ksmola/inverter-hardware/prius_gen2_kicad/prius_g2_cam/bom_jlc_order.xls

Comment | Designator | Package | LCSC Part
0603WAF1201T5E | R50,R51,R52,R53,R54 | Resistor_SMD:R_0603_1608Metric | C22765
PESD1CAN-UX | D2 | Package_TO_SOT_SMD:SOT-323_SC-70 | C152727
SMCJ30CA-TR | D4 | Diode_SMD:D_SMC | C152081
CL10B102KB8NNNC | C15,C16,C43,C44,C19 | Capacitor_SMD:C_0603_1608Metric | C1588
0603WAF2200T5E | R23 | Resistor_SMD:R_0603_1608Metric | C22962
TDA2822G-S08-R | U4 | Package_SO:SOIC-8-1EP_3.9x4.9mm_P1.27mm_EP2.29x3mm | C73296
GZ2012D101TF | FB1 | Capacitor_SMD:C_0805_2012Metric | C1015
CL10C331JB8NNNC | C39 | Capacitor_SMD:C_0603_1608Metric | C1664
MWSA0503-100MT | L2 | prius_gen2_kicad:MWSA0503 | C139506
0603WAF1202T5E | R39 | Resistor_SMD:R_0603_1608Metric | C22790
0603WAF5100T5E | R22,R41,R42,R55,R58,R59 | Resistor_SMD:R_0603_1608Metric | C23193
X50328MSB2GI | Y1 | Crystal:Crystal_SMD_5032-2Pin_5.0x3.2mm | C115962
CL10A475KO8NNNC | C34,C42,C3,C5,C6,C7,C8,C12 | Capacitor_SMD:C_0603_1608Metric | C19666
ESP32-WROOM-32 | U6 | RF_Module:ESP32-WROOM-32 | C82899
0603B103K500NT | C4,C10,C37 | Capacitor_SMD:C_0603_1608Metric | C57112
0603WAF1200T5E | R33 | Resistor_SMD:R_0603_1608Metric | C22787
CL10B223KB8NNNC | C22,C23,C24,C25,C27 | Capacitor_SMD:C_0603_1608Metric | C21122
CL10A106KP8NNNC | C26,C32,C18,C40,C41 | Capacitor_SMD:C_0603_1608Metric | C19702
TS-1187A-C-E-B | SW1,SW2,SW4,SW3 | Button_Switch_SMD:SW_SPST_EVQQ2 | C318887
AP9T18GH-HF | Q1,Q2 | Package_TO_SOT_SMD:TO-252-2 | C124546
0603WAF1002T5E | R4,R5,R6,R11,R18,R19,R20,R21,R24,R26,R1,R3,R30,R36,R38,R43,R44,R56,R57,R60,R61,R34 | Resistor_SMD:R_0603_1608Metric | C25804
LMR14020SDDAR | U7 | Package_SO:SOIC-8-1EP_3.9x4.9mm_P1.27mm_EP2.29x3mm | C187824
0603WAF3301T5E | R27,R28,R29,R46,R47,R48,R49 | Resistor_SMD:R_0603_1608Metric | C22978
0603WAF100KT5E | R37 | Resistor_SMD:R_0603_1608Metric | C22936
E6C0603QBAC1UDA | D1,D3 | LED_SMD:LED_0603_1608Metric_Castellated | C375446
MCP6022T-I/SN | U2 | Package_SO:SOIC-8-1EP_3.9x4.9mm_P1.27mm_EP2.29x3mm | C57639
0603WAF1000T5E | R35 | Resistor_SMD:R_0603_1608Metric | C22775
STM32F103R8T6 | U1 | Package_QFP:LQFP-64_10x10mm_P0.5mm | C46034
0603B104K250CT | C28,C29 | Capacitor_SMD:C_0603_1608Metric | C83054
CL10A105KB8NNNC | C14,C17,C45,C46,C47,C48,C49,C50,C51,C52,C20,C36 | Capacitor_SMD:C_0603_1608Metric | C15849
0603WAF1502T5E | R13,R15 | Resistor_SMD:R_0603_1608Metric | C22809
0603WAF3302T5E | R12,R14 | Resistor_SMD:R_0603_1608Metric | C4216
ULN2003ADR | U3 | Package_SO:SOIC-16_4.55x10.3mm_P1.27mm | C7512
0603WAF6800T5E | R2 | Resistor_SMD:R_0603_1608Metric | C23228
SS34 | D5,D6 | Diode_SMD:D_SMA | C8678
CC0603KRX7R9BB104 | C38 | Capacitor_SMD:C_0603_1608Metric | C14663
0603WAF6802T5E | R40 | Resistor_SMD:R_0603_1608Metric | C23231
TJA1051T/3/1J | U5 | Package_SO:SOIC-8_3.9x4.9mm_P1.27mm | C38695
CL10C330JB8NNNC | C1,C2 | Capacitor_SMD:C_0603_1608Metric | C1663
HMK107B7104KAHT | C30,C31,C33 | Capacitor_SMD:C_0603_1608Metric | C268011
AMS1117-3.3 | U8 | Package_TO_SOT_SMD:SOT-223-3_TabPin2 | C6186
LQH32PN2R2NN0L | L1 | Inductor_SMD:L_1210_3225Metric | C86074
0805W8F4701T5E | R25,R31,R32,R45 | Resistor_SMD:R_0603_1608Metric | C23162
0603WAF1003T5E | R7,R8,R9,R10,R16,R17 | Resistor_SMD:R_0603_1608Metric | C25803
