ksmola/inverter-hardware/prius_gen2_kicad/prius_gen2.kicad_pcb

## KiCad design prius_gen2_kicad/prius_gen2.kicad_pcb (2021-07-11)

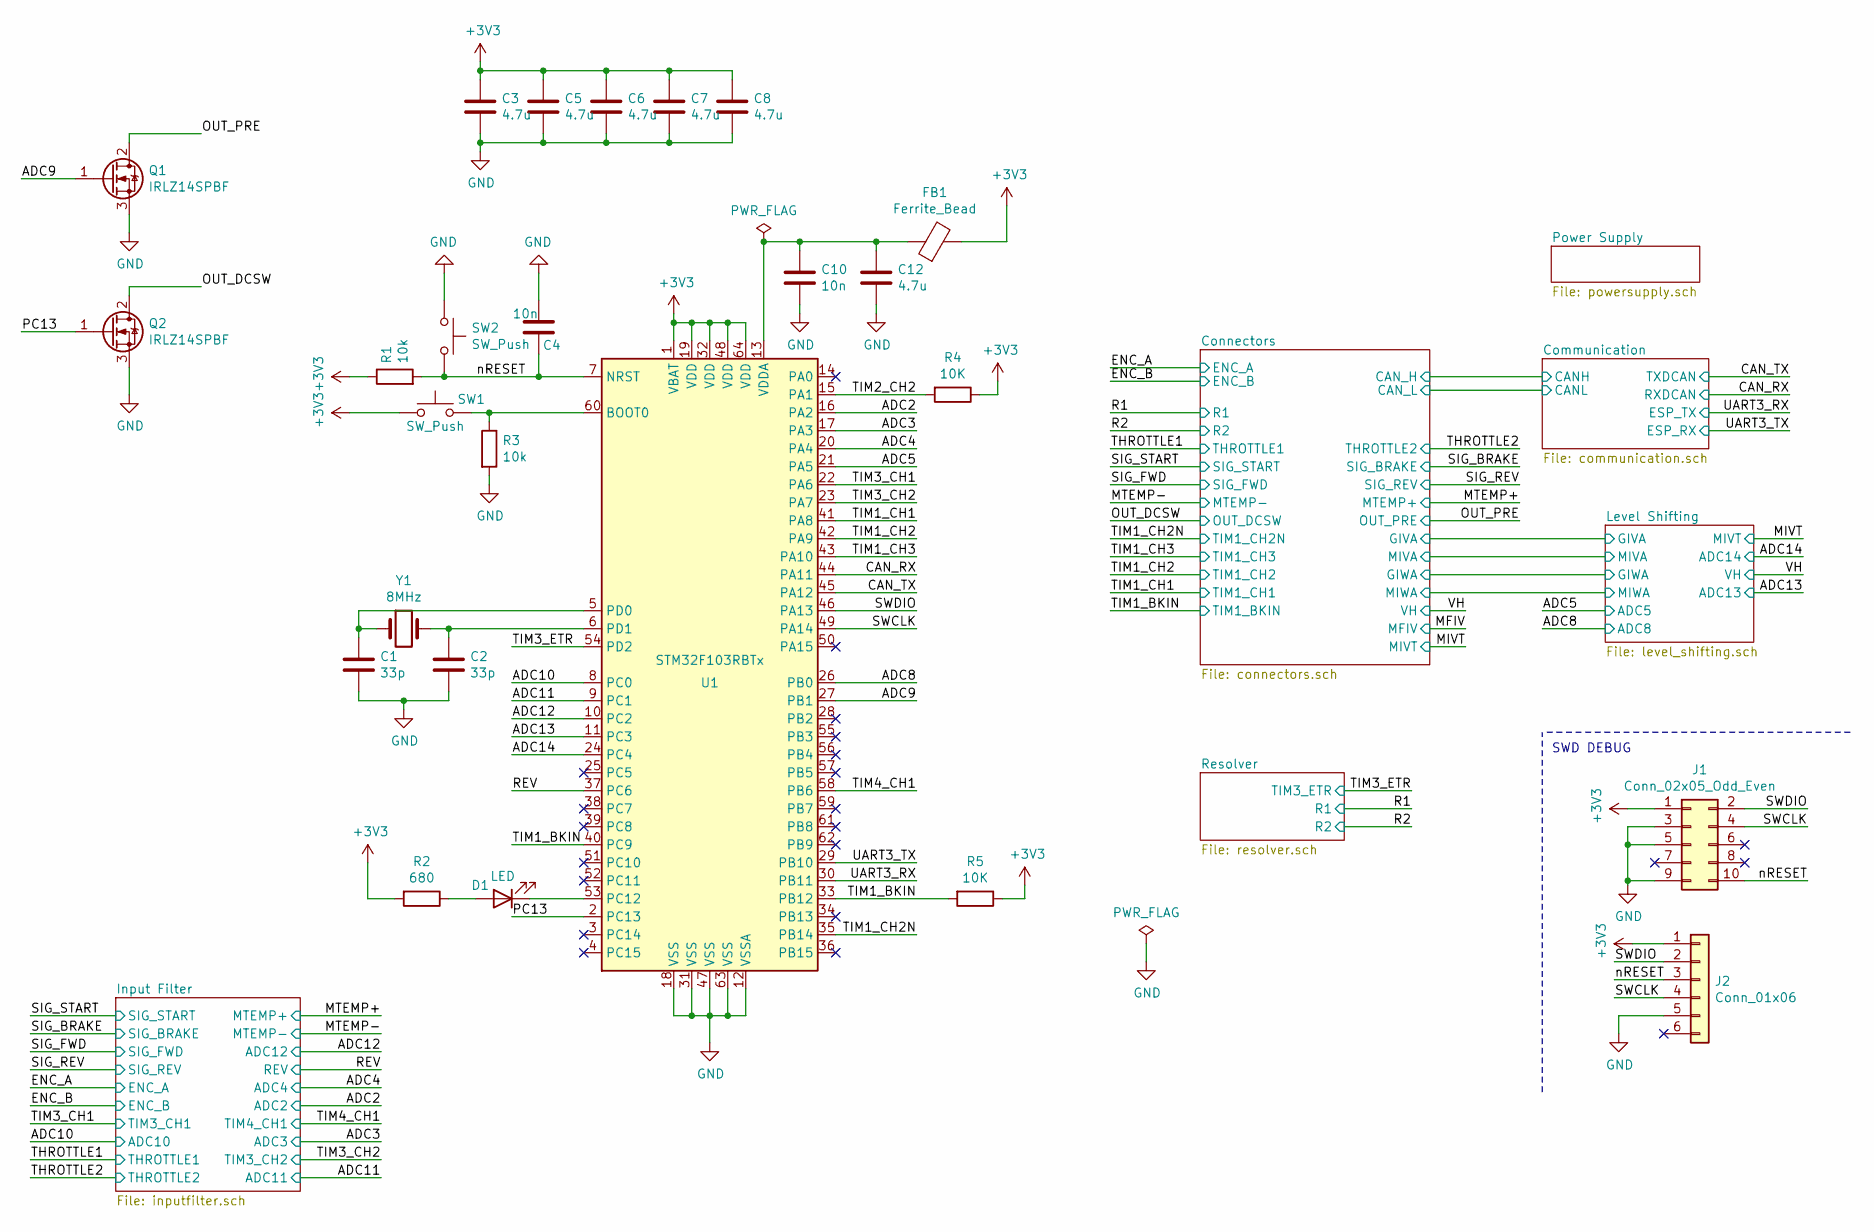
[picture p1: schematic prius_gen2.sch]

Parts:
C1, C2: 33p; C_0603_1608Metric
C3, C5, C6, C7, C8, C12: 4.7u; C_0603_1608Metric
C4, C10: 10n; C_0603_1608Metric
D1: LED; LED_0603_1608Metric_Castellated
FB1: Ferrite_Bead; C_0805_2012Metric
J1: Conn_02x05_Odd_Even; PinHeader_2x05_P1.27mm_Vertical_SMD
J2: Conn_01x06; Tag-Connect_TC2030-IDC-NL_2x03_P1.27mm_Vertical
Q1, Q2: IRLZ14SPBF; TO-252-2
R1, R3: 10k; R_0603_1608Metric
R2: 680; R_0603_1608Metric
R4, R5: 10K; R_0603_1608Metric
SW1, SW2: SW_Push; SW_SPST_EVQQ2
U1: STM32F103RBTx; LQFP-64_10x10mm_P0.5mm
Y1: 8MHz; Crystal_SMD_5032-2Pin_5.0x3.2mm

Connections:
/ADC2: U1.16 (PA2); also elsewhere on the board
/ADC3: U1.17 (PA3); also elsewhere on the board
/ADC4: U1.20 (PA4); also elsewhere on the board
/ADC5: U1.21 (PA5); also elsewhere on the board
/ADC8: U1.26 (PB0); also elsewhere on the board
/ADC9: Q1.1 (G), U1.27 (PB1)
/ADC10: U1.8 (PC0); also elsewhere on the board
/ADC11: U1.9 (PC1); also elsewhere on the board
/ADC12: U1.10 (PC2); also elsewhere on the board
/ADC13: U1.11 (PC3); also elsewhere on the board
/ADC14: U1.24 (PC4); also elsewhere on the board
/CAN_RX: U1.44 (PA11); also elsewhere on the board
/CAN_TX: U1.45 (PA12); also elsewhere on the board
/OUT_DCSW: Q2.2 (D); also elsewhere on the board
/OUT_PRE: Q1.2 (D); also elsewhere on the board
/PC13: Q2.1 (G), U1.2 (PC13)
/REV: U1.37 (PC6); also elsewhere on the board
/SWCLK: J1.4, J2.4, U1.49 (PA14)
/SWDIO: J1.2, J2.2, U1.46 (PA13)
/TIM1_BKIN: R5.2, U1.33 (PB12), U1.40 (PC9); also elsewhere on the board
/TIM1_CH1: U1.41 (PA8); also elsewhere on the board
/TIM1_CH2: U1.42 (PA9); also elsewhere on the board
/TIM1_CH2N: U1.35 (PB14); also elsewhere on the board
/TIM1_CH3: U1.43 (PA10); also elsewhere on the board
/TIM2_CH2: R4.2, U1.15 (PA1)
/TIM3_CH1: U1.22 (PA6); also elsewhere on the board
/TIM3_CH2: U1.23 (PA7); also elsewhere on the board
/TIM3_ETR: U1.54 (PD2); also elsewhere on the board
/TIM4_CH1: U1.58 (PB6); also elsewhere on the board
/UART3_RX: U1.30 (PB11); also elsewhere on the board
/UART3_TX: U1.29 (PB10); also elsewhere on the board
/nRESET: C4.1, J1.10, J2.3, R1.2, SW2.2, U1.7 (NRST)
GND: C1.1, C2.1, C3.2, C4.2, C5.2, C6.2, C7.2, C8.2, C10.2, C12.2, J1.3, J1.5, J1.9, J2.5, Q1.3 (S), Q2.3 (S), R3.2, SW2.1, U1.12 (VSSA), U1.18 (VSS), U1.31 (VSS), U1.47 (VSS), U1.63 (VSS); also elsewhere on the board
unnamed: C1.2, U1.5 (PD0), Y1.1
unnamed: C2.2, U1.6 (PD1), Y1.2
unnamed: C10.1, C12.1, FB1.1, U1.13 (VDDA)
unnamed: D1.1 (K), U1.53 (PC12)
unnamed: D1.2 (A), R2.1
unnamed: R3.1, SW1.2, U1.60 (BOOT0)

Notes on the sheet:
SWD DEBUG

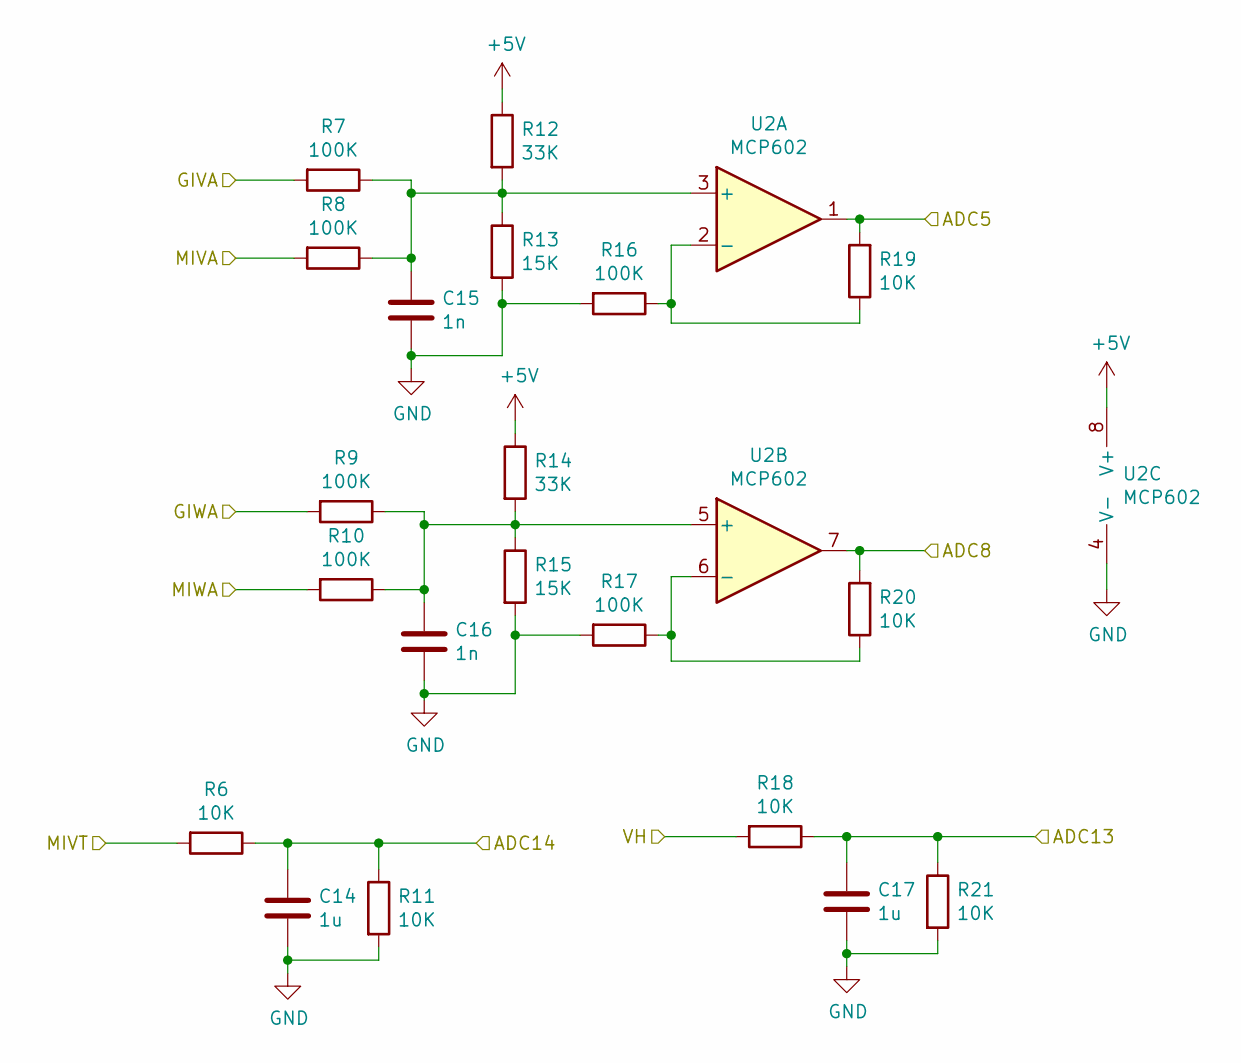
[picture p2: schematic level_shifting.sch]

Parts:
C14, C17: 1u; C_0603_1608Metric
C15, C16: 1n; C_0603_1608Metric
R6, R11, R18, R19, R20, R21: 10K; R_0603_1608Metric
R7, R8, R9, R10, R16, R17: 100K; R_0603_1608Metric
R12, R14: 33K; R_0603_1608Metric
R13, R15: 15K; R_0603_1608Metric
U2: MCP602; SOIC-8-1EP_3.9x4.9mm_P1.27mm_EP2.29x3mm

Connections:
+5V: R12.1, R14.1, U2.8 (V+); also elsewhere on the board
/ADC5: R19.2, U2.1; also elsewhere on the board
/ADC8: R20.2, U2.7; also elsewhere on the board
/ADC13: C17.1, R18.1, R21.1; also elsewhere on the board
/ADC14: C14.1, R6.1, R11.1; also elsewhere on the board
/Connectors/GIVA: R7.2; also elsewhere on the board
/Connectors/GIWA: R9.2; also elsewhere on the board
/Connectors/MIVA: R8.2; also elsewhere on the board
/Connectors/MIWA: R10.2; also elsewhere on the board
/MIVT: R6.2; also elsewhere on the board
/VH: R18.2; also elsewhere on the board
GND: C14.2, C15.2, C16.2, C17.2, R11.2, R13.2, R15.2, R16.2, R17.2, R21.2, U2.4 (V-); also elsewhere on the board
unnamed: C15.1, R7.1, R8.1, R12.2, R13.1, U2.3 (+)
unnamed: C16.1, R9.1, R10.1, R14.2, R15.1, U2.5 (+)
unnamed: R16.1, R19.1, U2.2 (-)
unnamed: R17.1, R20.1, U2.6 (-)

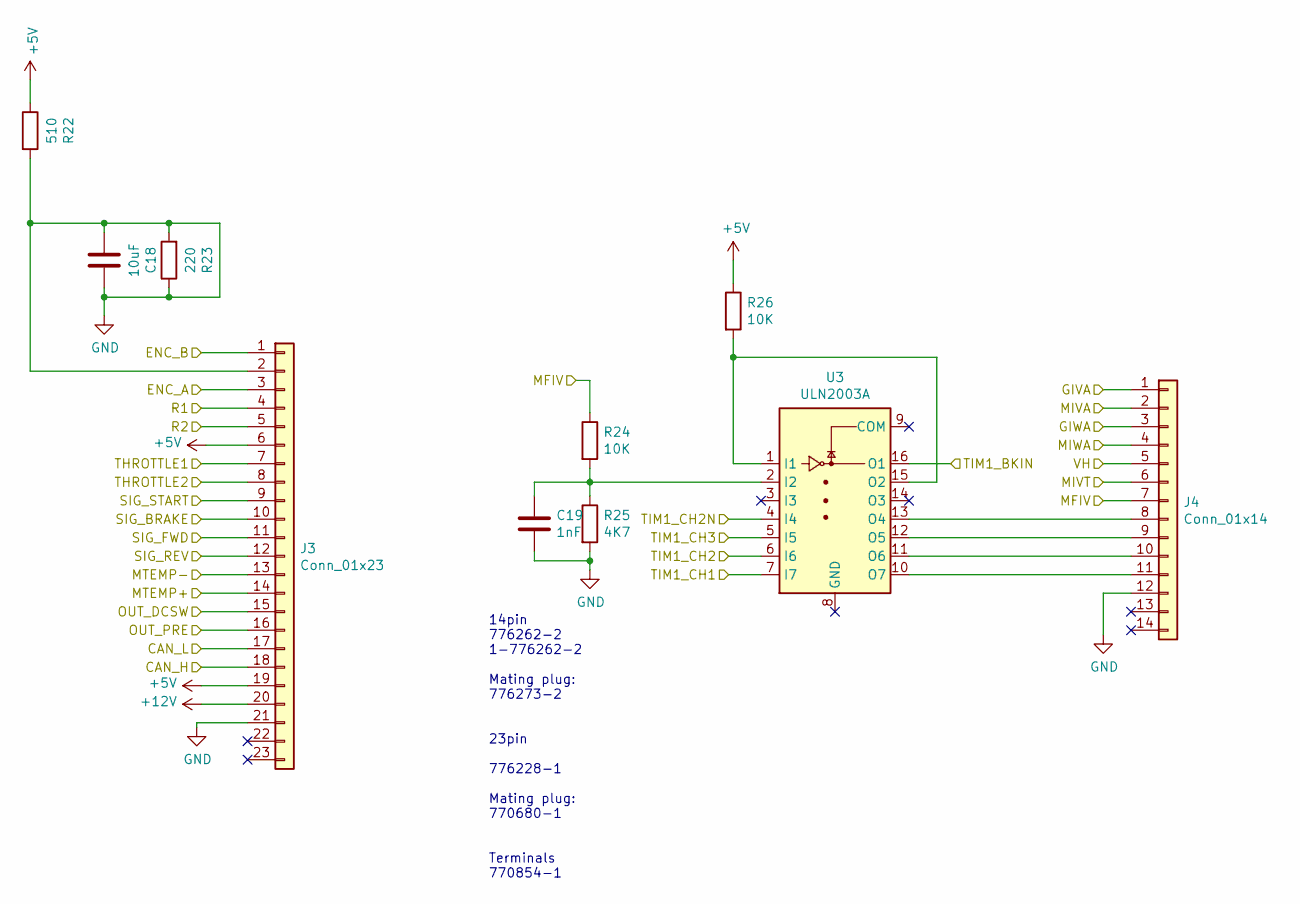
[picture p3: schematic connectors.sch]

Parts:
C18: 10uF; C_0603_1608Metric
C19: 1nF; C_0603_1608Metric
J3: Conn_01x23; TE_776228-1
J4: Conn_01x14; TE_776262-2
R22: 510; R_0603_1608Metric
R23: 220; R_0603_1608Metric
R24, R26: 10K; R_0603_1608Metric
R25: 4K7; R_0603_1608Metric
U3: ULN2003A; SOIC-16_4.55x10.3mm_P1.27mm

Connections:
+5V: J3.6, J3.19, R22.1, R26.1; also elsewhere on the board
+12V: J3.20; also elsewhere on the board
/Communication/CANH: J3.18; also elsewhere on the board
/Communication/CANL: J3.17; also elsewhere on the board
/Connectors/GIVA: J4.1; also elsewhere on the board
/Connectors/GIWA: J4.3; also elsewhere on the board
/Connectors/MIVA: J4.2; also elsewhere on the board
/Connectors/MIWA: J4.4; also elsewhere on the board
/ENC_A: J3.3; also elsewhere on the board
/ENC_B: J3.1; also elsewhere on the board
/MFIV: J4.7, R24.1
/MIVT: J4.6; also elsewhere on the board
/MTEMP+: J3.14; also elsewhere on the board
/MTEMP-: J3.13; also elsewhere on the board
/OUT_DCSW: J3.15; also elsewhere on the board
/OUT_PRE: J3.16; also elsewhere on the board
/R1: J3.4; also elsewhere on the board
/R2: J3.5; also elsewhere on the board
/SIG_BRAKE: J3.10; also elsewhere on the board
/SIG_FWD: J3.11; also elsewhere on the board
/SIG_REV: J3.12; also elsewhere on the board
/SIG_START: J3.9; also elsewhere on the board
/THROTTLE1: J3.7; also elsewhere on the board
/THROTTLE2: J3.8; also elsewhere on the board
/TIM1_BKIN: U3.16 (O1); also elsewhere on the board
/TIM1_CH1: U3.7 (I7); also elsewhere on the board
/TIM1_CH2: U3.6 (I6); also elsewhere on the board
/TIM1_CH2N: U3.4 (I4); also elsewhere on the board
/TIM1_CH3: U3.5 (I5); also elsewhere on the board
/VH: J4.5; also elsewhere on the board
GND: C18.1, C18.2, C19.2, J3.2, J3.21, J4.12, R22.2, R23.1, R23.2, R25.2; also elsewhere on the board
unnamed: C19.1, R24.2, R25.1, U3.2 (I2)
unnamed: J4.8, U3.13 (O4)
unnamed: J4.9, U3.12 (O5)
unnamed: J4.10, U3.11 (O6)
unnamed: J4.11, U3.10 (O7)
unnamed: R26.2, U3.1 (I1), U3.15 (O2)

Notes on the sheet:
14pin 776262-2 1-776262-2 Mating plug: 776273-2 23pin 776228-1 Mating plug: 770680-1 Terminals 770854-1

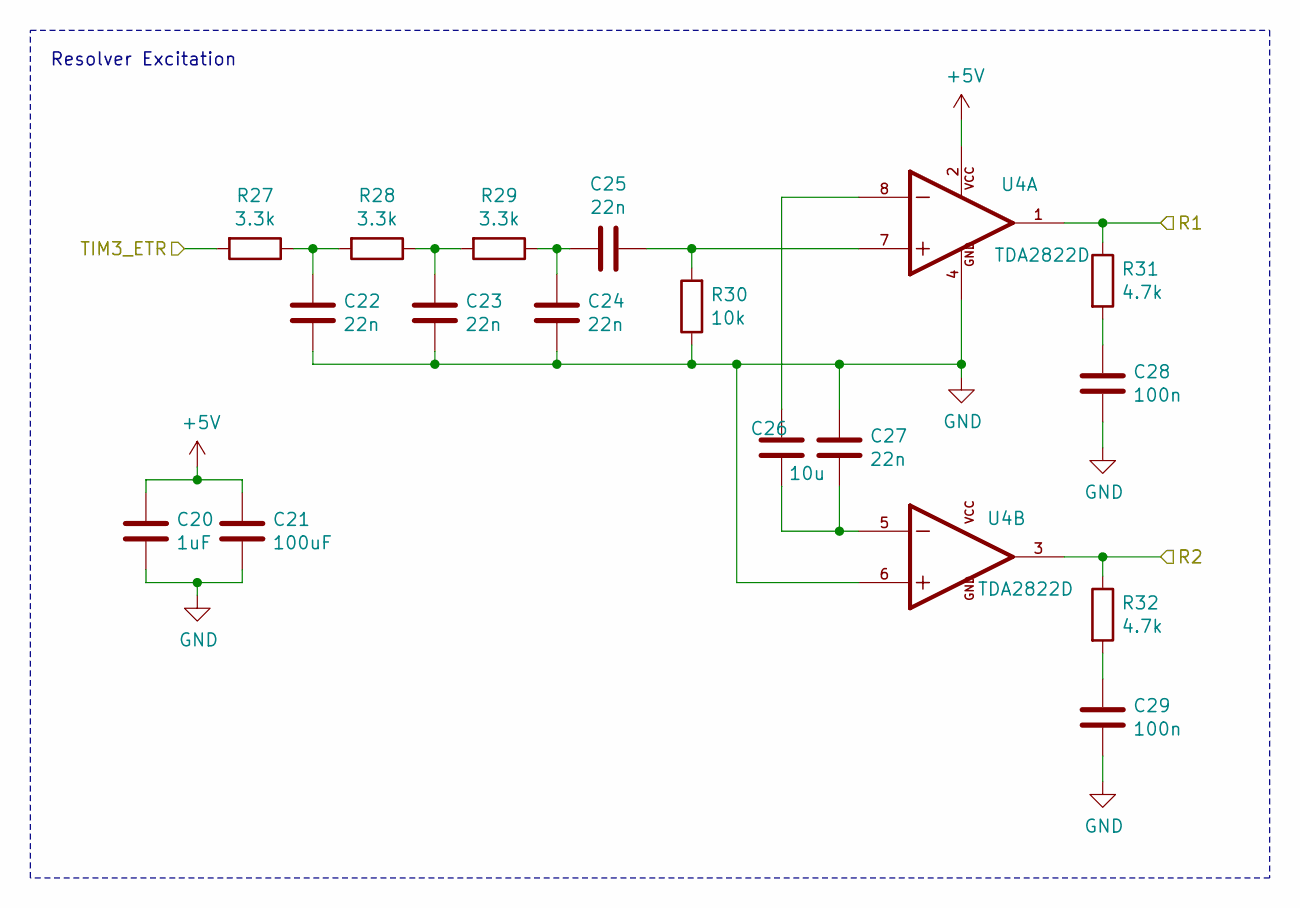
[picture p4: schematic resolver.sch]

Parts:
C20: 1uF; C_0603_1608Metric
C21: 100uF; C_Elec_6.3x7.7
C22, C23, C24, C25, C27: 22n; C_0603_1608Metric
C26: 10u; C_0603_1608Metric
C28, C29: 100n; C_0603_1608Metric
R27, R28, R29: 3.3k; R_0603_1608Metric
R30: 10k; R_0603_1608Metric
R31, R32: 4.7k; R_0603_1608Metric
U4: TDA2822D; SOIC-8-1EP_3.9x4.9mm_P1.27mm_EP2.29x3mm; PARTREV September 2003

Connections:
+5V: C20.1, C21.1, U4.2; also elsewhere on the board
/R1: R31.1, U4.1; also elsewhere on the board
/R2: R32.1, U4.3; also elsewhere on the board
/TIM3_ETR: R27.2; also elsewhere on the board
GND: C20.2, C21.2, C22.2, C23.2, C24.2, C27.1, C28.2, C29.2, R30.1, U4.4, U4.6; also elsewhere on the board
unnamed: C22.1, R27.1, R28.2
unnamed: C23.1, R28.1, R29.2
unnamed: C24.1, C25.2, R29.1
unnamed: C25.1, R30.2, U4.7
unnamed: C26.1, U4.8
unnamed: C26.2, C27.2, U4.5
unnamed: C28.1, R31.2
unnamed: C29.1, R32.2

Notes on the sheet:
Resolver Excitation

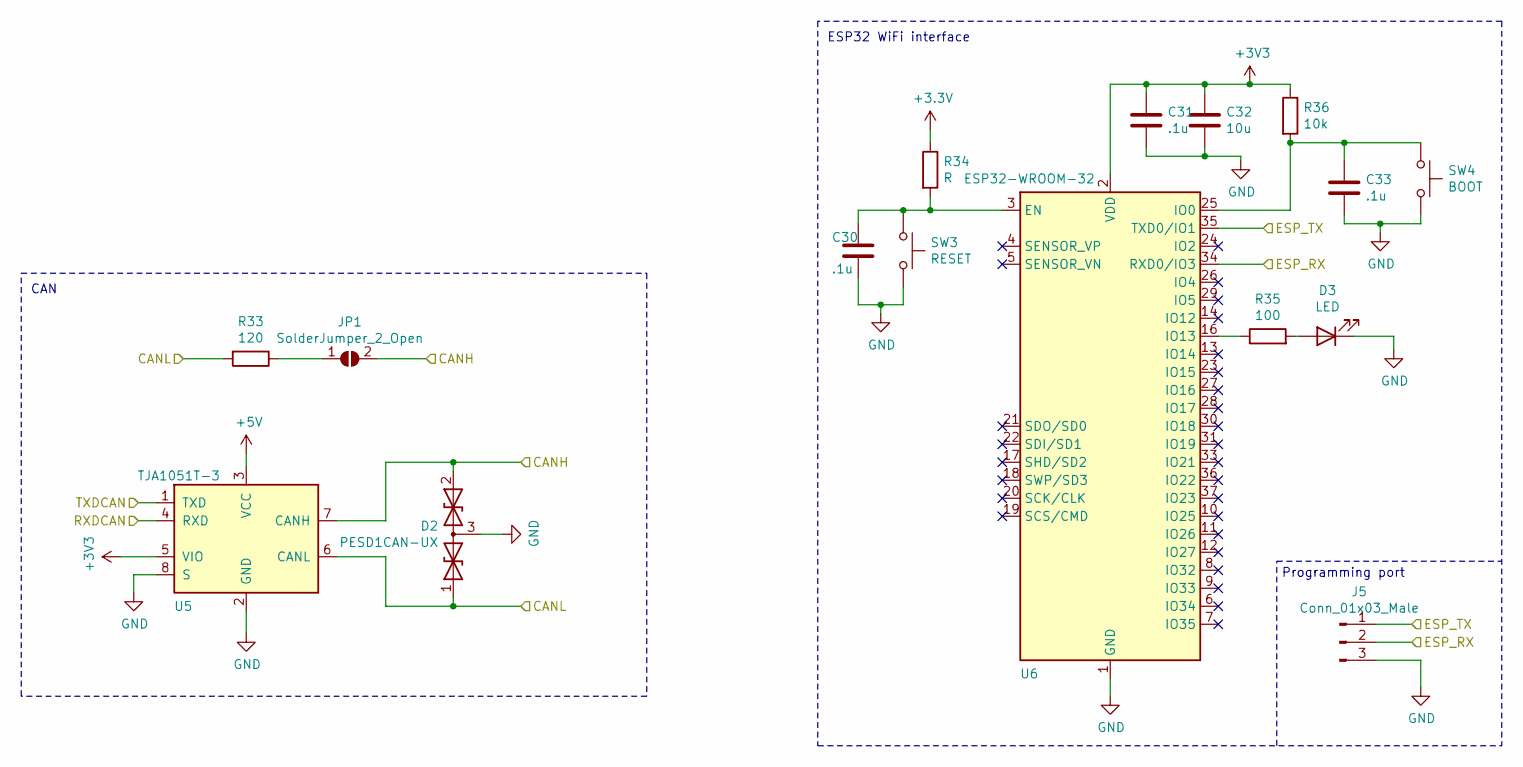
[picture p5: schematic communication.sch]

Parts:
C30, C31, C33: .1u; C_0603_1608Metric
C32: 10u; C_0603_1608Metric
D2: PESD1CAN-UX; SOT-323_SC-70
D3: LED; LED_0603_1608Metric_Castellated
J5: Conn_01x03_Male; PinSocket_1x03_P1.27mm_Vertical_SMD_Pin1Left
JP1: SolderJumper_2_Open; SolderJumper-2_P1.3mm_Open_TrianglePad1.0x1.5mm
R33: 120; R_0603_1608Metric
R34: R; R_0603_1608Metric
R35: 100; R_0603_1608Metric
R36: 10k; R_0603_1608Metric
SW3: RESET; SW_SPST_EVQQ2
SW4: BOOT; SW_SPST_EVQQ2
U5: TJA1051T-3; SOIC-8_3.9x4.9mm_P1.27mm
U6: ESP32-WROOM-32

Connections:
+5V: U5.3 (VCC); also elsewhere on the board
/CAN_RX: U5.4 (RXD); also elsewhere on the board
/CAN_TX: U5.1 (TXD); also elsewhere on the board
/Communication/CANH: D2.2 (A2), JP1.2 (B), U5.7 (CANH); also elsewhere on the board
/Communication/CANL: D2.1 (A1), R33.2, U5.6 (CANL); also elsewhere on the board
/UART3_RX: J5.1, U6.35 (TXD0/IO1); also elsewhere on the board
/UART3_TX: J5.2, U6.34 (RXD0/IO3); also elsewhere on the board
GND: C30.2, C31.2, C32.2, C33.2, D2.3 (common), D3.1 (K), J5.3, SW3.2, SW4.2, U5.2 (GND), U5.8 (S), U6.1 (GND), U6.15 (GND), U6.38 (GND), U6.39 (GND); also elsewhere on the board
unnamed: C30.1, R34.2, SW3.1, U6.3 (EN)
unnamed: C33.1, R36.2, SW4.1, U6.25 (IO0)
unnamed: D3.2 (A), R35.2
unnamed: JP1.1 (A), R33.1
unnamed: R35.1, U6.16 (IO13)

Notes on the sheet:
Programming port
CAN
ESP32 WiFi interface

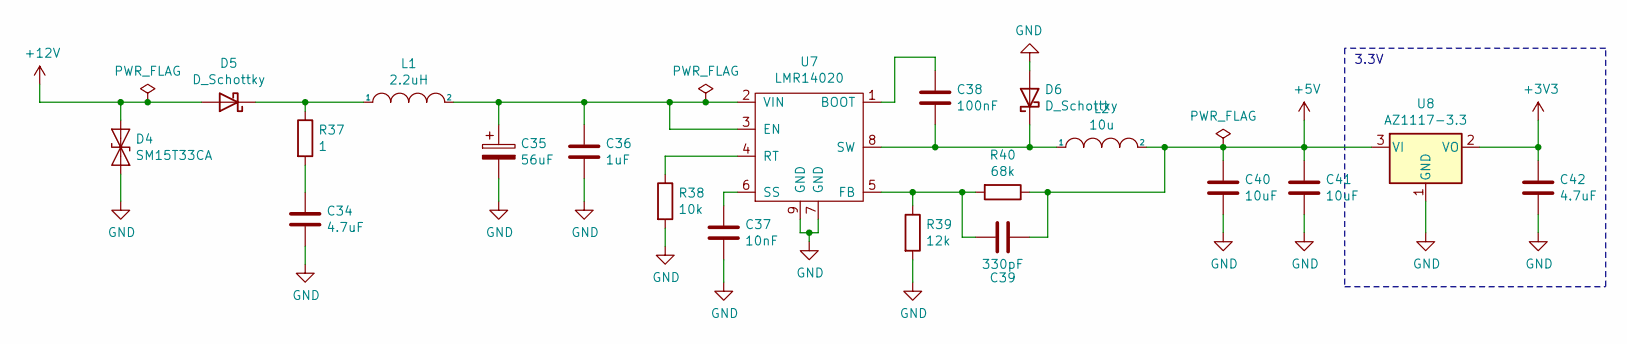
[picture p6: schematic powersupply.sch]

Parts:
C34, C42: 4.7uF; C_0603_1608Metric
C35: 56uF; CP_Radial_D8.0mm_P3.50mm
C36: 1uF; C_0603_1608Metric
C37: 10nF; C_0603_1608Metric
C38: 100nF; C_0603_1608Metric
C39: 330pF; C_0603_1608Metric
C40, C41: 10uF; C_0603_1608Metric
D4: SM15T33CA; D_SMC
D5, D6: D_Schottky; D_SMA
L1: 2.2uH; L_1210_3225Metric
L2: 10u; MWSA0503
R37: 1; R_0603_1608Metric
R38: 10k; R_0603_1608Metric
R39: 12k; R_0603_1608Metric
R40: 68k; R_0603_1608Metric
U7: LMR14020; SOIC-8-1EP_3.9x4.9mm_P1.27mm_EP2.29x3mm
U8: AZ1117-3.3; SOT-223-3_TabPin2

Connections:
+5V: C39.2, C40.1, C41.1, L2.2, R40.1, U8.3 (VI); also elsewhere on the board
+12V: D4.1 (A1), D5.2 (A); also elsewhere on the board
GND: C34.2, C35.2, C36.2, C37.2, C40.2, C41.2, C42.2, D4.2 (A2), D6.2 (A), R38.2, R39.2, U7.7 (GND), U7.9 (GND), U8.1 (GND); also elsewhere on the board
unnamed: C34.1, R37.2
unnamed: C35.1, C36.1, L1.2, U7.2 (VIN), U7.3 (EN)
unnamed: C37.1, U7.6 (SS)
unnamed: C38.1, U7.1 (BOOT)
unnamed: C38.2, D6.1 (K), L2.1, U7.8 (SW)
unnamed: C39.1, R39.1, R40.2, U7.5 (FB)
unnamed: D5.1 (K), L1.1, R37.1
unnamed: R38.1, U7.4 (RT)

Notes on the sheet:
3.3V

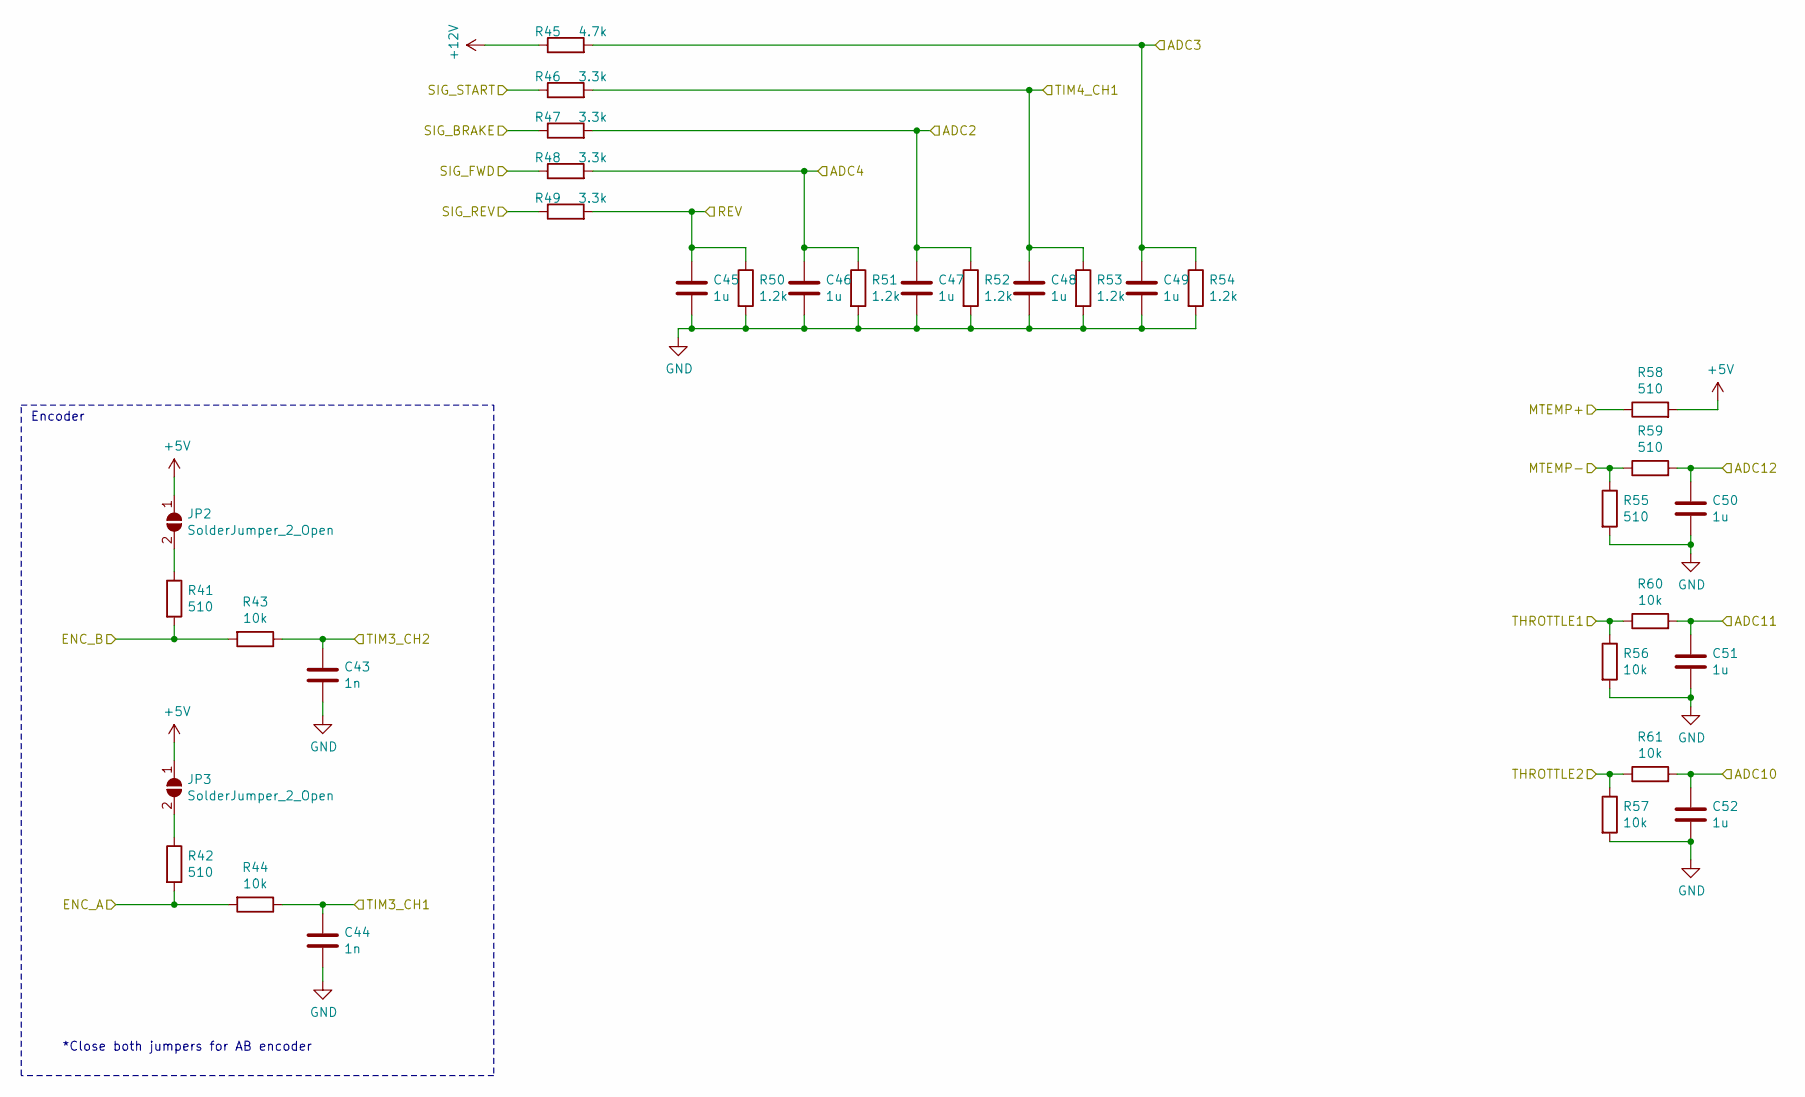
[picture p7: schematic inputfilter.sch]

Parts:
C43, C44: 1n; C_0603_1608Metric
C45, C46, C47, C48, C49, C50, C51, C52: 1u; C_0603_1608Metric
JP2, JP3: SolderJumper_2_Open; SolderJumper-2_P1.3mm_Open_TrianglePad1.0x1.5mm
R41, R42, R55, R58, R59: 510; R_0603_1608Metric
R43, R44, R56, R57, R60, R61: 10k; R_0603_1608Metric
R45: 4.7k; R_0603_1608Metric
R46, R47, R48, R49: 3.3k; R_0603_1608Metric
R50, R51, R52, R53, R54: 1.2k; R_0603_1608Metric

Connections:
+5V: JP2.1 (A), JP3.1 (A), R58.2; also elsewhere on the board
+12V: R45.1; also elsewhere on the board
/ADC2: C47.1, R47.2, R52.1; also elsewhere on the board
/ADC3: C49.1, R45.2, R54.1; also elsewhere on the board
/ADC4: C46.1, R48.2, R51.1; also elsewhere on the board
/ADC10: C52.1, R61.2; also elsewhere on the board
/ADC11: C51.1, R60.2; also elsewhere on the board
/ADC12: C50.1, R59.2; also elsewhere on the board
/ENC_A: R42.2, R44.2; also elsewhere on the board
/ENC_B: R41.2, R43.2; also elsewhere on the board
/MTEMP+: R58.1; also elsewhere on the board
/MTEMP-: R55.1, R59.1; also elsewhere on the board
/REV: C45.1, R49.2, R50.1; also elsewhere on the board
/SIG_BRAKE: R47.1; also elsewhere on the board
/SIG_FWD: R48.1; also elsewhere on the board
/SIG_REV: R49.1; also elsewhere on the board
/SIG_START: R46.1; also elsewhere on the board
/THROTTLE1: R56.1, R60.1; also elsewhere on the board
/THROTTLE2: R57.1, R61.1; also elsewhere on the board
/TIM3_CH1: C44.1, R44.1; also elsewhere on the board
/TIM3_CH2: C43.1, R43.1; also elsewhere on the board
/TIM4_CH1: C48.1, R46.2, R53.1; also elsewhere on the board
GND: C43.2, C44.2, C45.2, C46.2, C47.2, C48.2, C49.2, C50.2, C51.2, C52.2, R50.2, R51.2, R52.2, R53.2, R54.2, R55.2, R56.2, R57.2; also elsewhere on the board
unnamed: JP2.2 (B), R41.1
unnamed: JP3.2 (B), R42.1

Notes on the sheet:
Encoder
*Close both jumpers for AB encoder

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
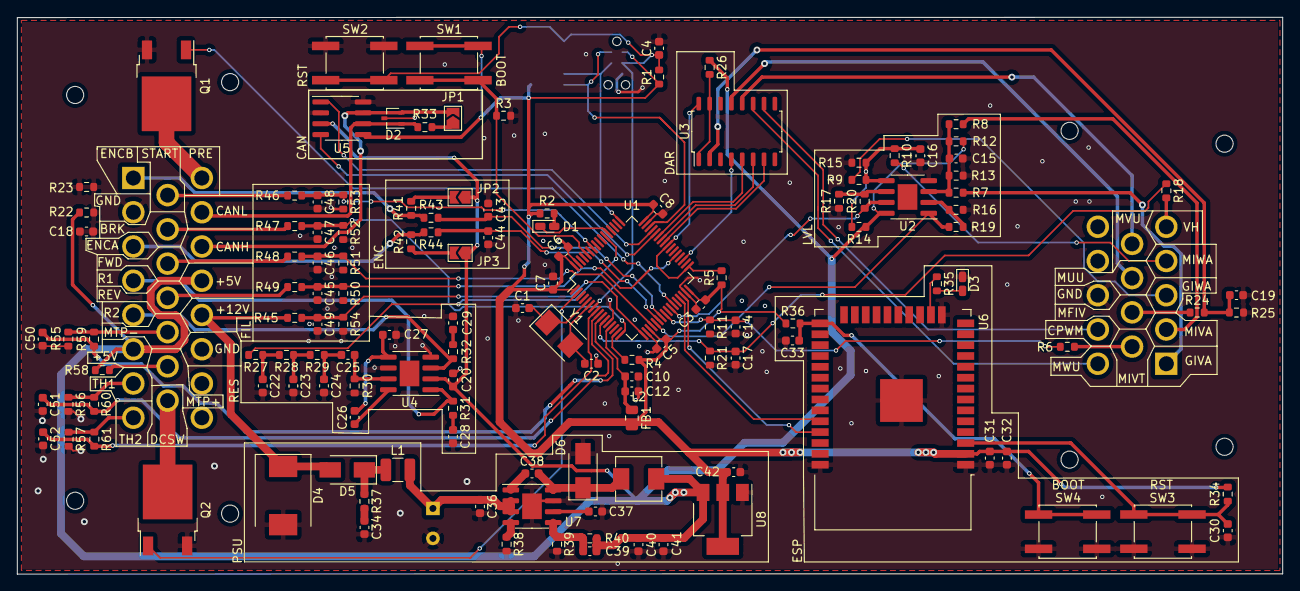
[picture p8: board prius_gen2.kicad_pcb from above]

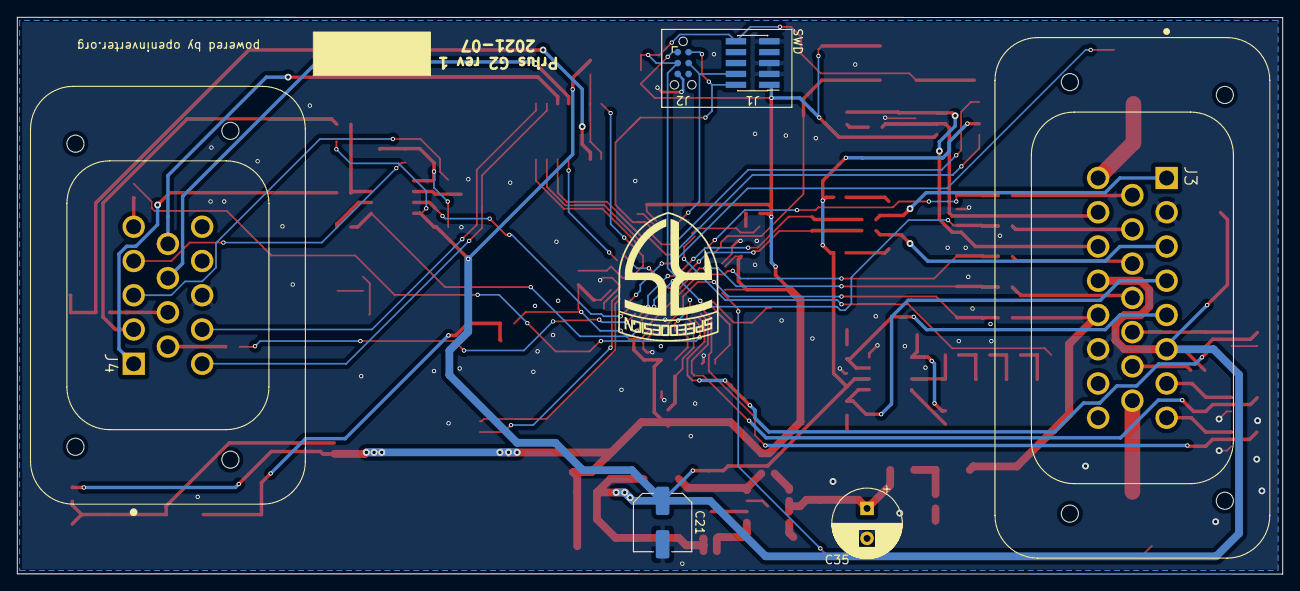
[picture p9: board prius_gen2.kicad_pcb from below]

Board: 2 copper layers, 147.8 x 65.0 mm, 141 parts (6 on the bottom side), 96 nets.
