ksmola/inverter-hardware/(commit log)

2021-06-24 prius gen2 kicad, first steps
    [connectors.sch, level_shifting.sch, prius_gen2.kicad_pcb, prius_gen2.sch]
2021-07-02 more schematics
    [communication.sch, connectors.sch, level_shifting.sch, prius_gen2.sch, resolver.sch]
2021-07-04 schematics almost done
    [communication.sch, connectors.sch, inputfilter.sch, level_shifting.sch, powersupply.sch, prius_gen2.sch, resolver.sch]
2021-07-04 fixed ERC
    [communication.sch, connectors.sch, inputfilter.sch, level_shifting.sch, powersupply.sch, prius_gen2.sch, resolver.sch]
2021-07-05 started routing
    [communication.sch, connectors.sch, inputfilter.sch, level_shifting.sch, powersupply.sch, prius_gen2.kicad_pcb, prius_gen2.sch, resolver.sch]
2021-07-11 cam and more...
    [bom_jlc_order.xls, communication.sch, powersupply.sch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]
